quark-works/corne73/PCB/cherry-hotswap/corne73.kicad_pcb

## KiCad design PCB/cherry-hotswap/corne73.kicad_pcb (2026-07-16)

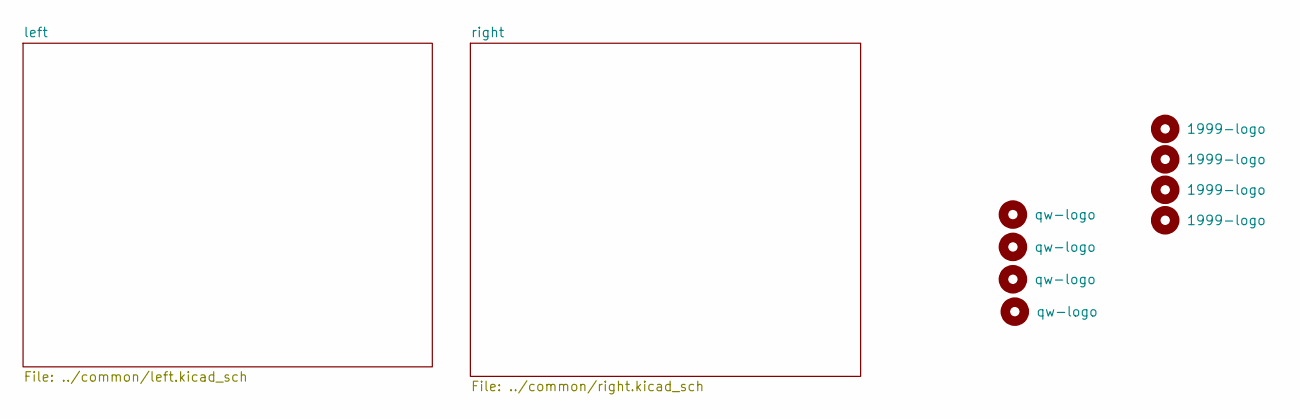
[picture p1: schematic corne73.kicad_sch, Corne]

Parts:
H1, H2, H3, H4: qw-logo; qw new logo silk + copper sm
H5, H6, H7, H8: 1999-logo; 1999 logo md

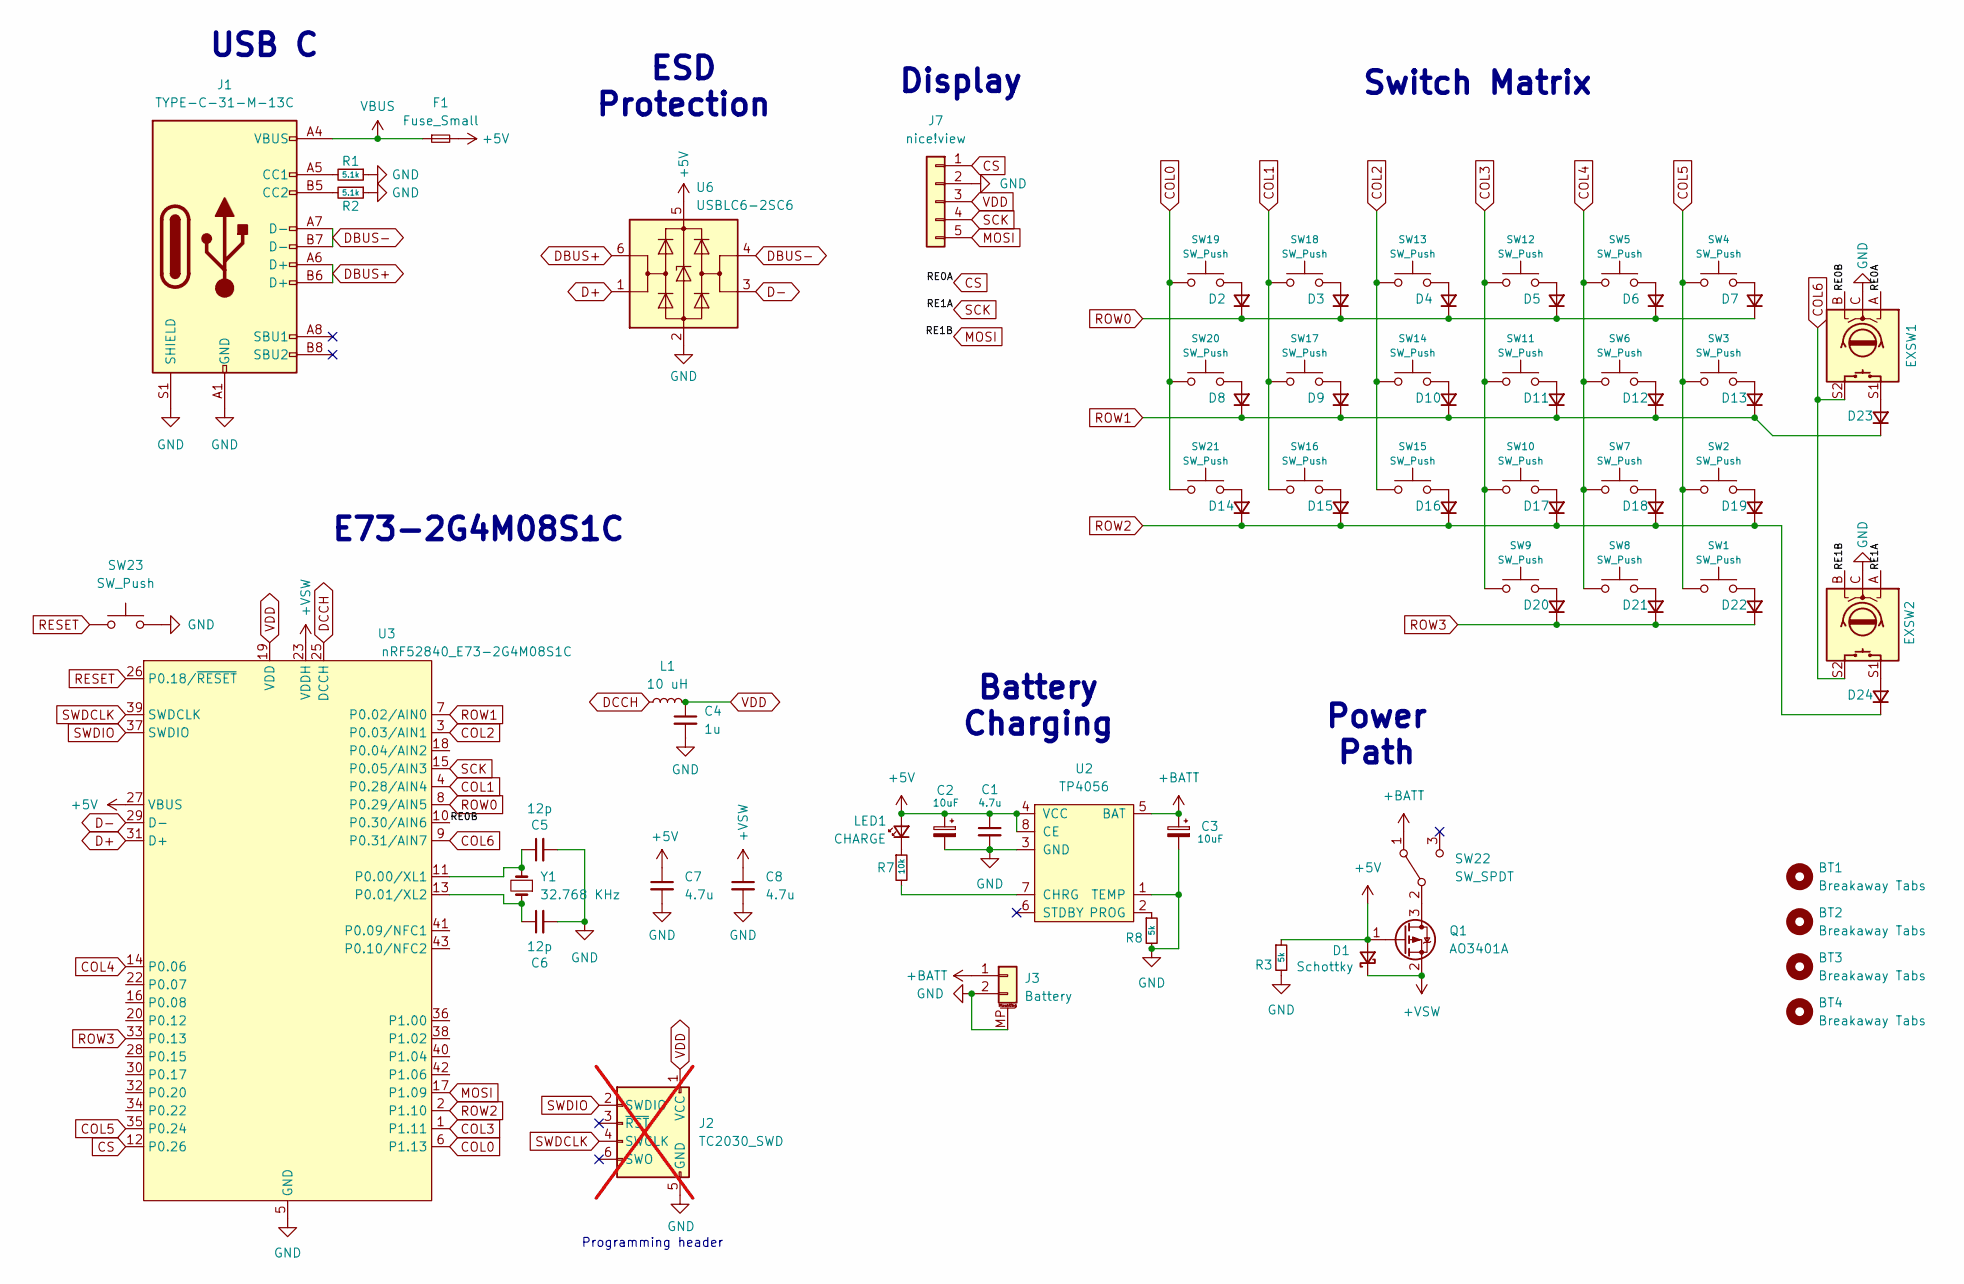
[picture p2: schematic left.kicad_sch, Corne Left]

Parts:
BT1, BT2, BT3, BT4: Breakaway Tabs; Breakaway_Tabs
C1, C7, C8: 4.7u; C_0603_1608Metric
C2, C3: 10uF; CP_EIA-2012-12_Kemet-R
C4: 1u; C_0603_1608Metric
C5, C6: 12p; C_0603_1608Metric
D1: Schottky; D_SOD-123
D2, D3, D4, D5, D6, D7, D8, D9, D10, D11, D12, D13, D14, D15, D16, D17, D18, D19, D20, D21, D22, D23, D24: 1N4148; D_SOD-123
EXSW1, EXSW2: RotaryEncoder_Switch; SwitchCombo+Encoder
F1: Fuse_Small; Fuse_1206_3216Metric
J1: TYPE-C-31-M-13C; JLCPCB Part # C2848620
J2: TC2030_SWD; CON_TC2030_outlined; not fitted
J3: Battery; Molex_Pico-EZmate_78171-0002_1x02-1MP_P1.20mm_Vertical
J7: nice!view; PinHeader_1x05_P2.54mm_Vertical
L1: 10 uH; L_0603_1608Metric; LCSC C92982
LED1: CHARGE; LED_0805_2012Metric
Q1: AO3401A; SOT-23
R1, R2: 5.1k; R_0402_1005Metric
R3, R8: 5k; R_0603_1608Metric
R7: 10k; R_0603_1608Metric
SW1, SW2, SW3, SW4, SW5, SW6, SW7, SW8, SW9, SW10, SW11, SW12, SW13, SW14, SW15, SW16, SW17, SW18, SW19, SW20, SW21: SW_Push; SwitchCombo
SW22: SW_SPDT; SW_SPDT_PCM12; LCSC C136720
SW23: SW_Push; SW_T1A2QR
U2: TP4056; CustomTP4056; LCSC C16581
U3: nRF52840_E73-2G4M08S1C; LCSC C356849
U6: USBLC6-2SC6; SOT-23-6
Y1: 32.768 KHz; Crystal_SMD_2012-2Pin_2.0x1.2mm; LCSC C55208

Connections:
+5V: C1.1, C2.1, C7.1, D1.2 (A), F1.2, LED1.2 (A), Q1.1 (G), R3.1, U2.4 (VCC), U2.8 (CE), U3.27 (VBUS), U6.5 (VBUS)
+BATT: C3.1, J3.1, SW22.1 (A), U2.5 (BAT)
+VSW: C8.1, D1.1 (K), Q1.2 (S), U3.23 (VDDH)
/left/RE0B: EXSW1.B, U3.10 (P0.30/AIN6)
COL0: SW19.2, SW20.2, SW21.2, U3.6 (P1.13)
COL1: SW16.2, SW17.2, SW18.2, U3.4 (P0.28/AIN4)
COL2: SW13.2, SW14.2, SW15.2, U3.3 (P0.03/AIN1)
COL3: SW9.2, SW10.2, SW11.2, SW12.2, U3.1 (P1.11)
COL4: SW5.2, SW6.2, SW7.2, SW8.2, U3.14 (P0.06)
COL5: SW1.2, SW2.2, SW3.2, SW4.2, U3.35 (P0.24)
COL6: EXSW1.S2, EXSW2.S2, U3.9 (P0.31/AIN7)
CS: EXSW1.A, J7.1, U3.12 (P0.26)
D+: U3.31 (D+), U6.1 (I/O1)
D-: U3.29 (D-), U6.3 (I/O2)
DBUS+: J1.A6 (D+), J1.B6 (D+), U6.6 (I/O1)
DBUS-: J1.A7 (D-), J1.B7 (D-), U6.4 (I/O2)
DCCH: L1.1, U3.25 (DCCH)
GND: C1.2, C2.2, C3.2, C4.2, C5.2, C6.2, C7.2, C8.2, EXSW1.C, EXSW2.C, J1.A1 (GND), J1.A12 (GND), J1.B1 (GND), J1.B12 (GND), J1.S1 (SHIELD), J2.5 (GND), J3.2, J3.MP (MountPin), J7.2, R1.1, R2.1, R3.2, R8.2, SW23.2, U2.1 (TEMP), U2.3 (GND), U3.5 (GND), U3.21 (GND), U3.24 (GND), U6.2 (GND)
MOSI: EXSW2.B, J7.5, U3.17 (P1.09)
unnamed: D2.2 (A), SW19.1
unnamed: D3.2 (A), SW18.1
unnamed: D4.2 (A), SW13.1
unnamed: D5.2 (A), SW12.1
unnamed: D6.2 (A), SW5.1
unnamed: D7.2 (A), SW4.1
unnamed: D8.2 (A), SW20.1
unnamed: D9.2 (A), SW17.1
unnamed: D10.2 (A), SW14.1
unnamed: D11.2 (A), SW11.1
unnamed: D12.2 (A), SW6.1
unnamed: D13.2 (A), SW3.1
unnamed: D14.2 (A), SW21.1
unnamed: D15.2 (A), SW16.1
unnamed: D16.2 (A), SW15.1
unnamed: D17.2 (A), SW10.1
unnamed: D18.2 (A), SW7.1
unnamed: D19.2 (A), SW2.1
unnamed: D20.2 (A), SW9.1
unnamed: D21.2 (A), SW8.1
unnamed: D22.2 (A), SW1.1
unnamed: D23.2 (A), EXSW1.S1
unnamed: D24.2 (A), EXSW2.S1
unnamed: J1.A5 (CC1), R1.2
unnamed: J1.B5 (CC2), R2.2
unnamed: LED1.1 (K), R7.1
unnamed: Q1.3 (D), SW22.2 (B)
unnamed: R7.2, U2.7 (CHRG)
unnamed: R8.1, U2.2 (PROG)
unnamed: C5.1, U3.11 (P0.00/XL1), Y1.2
unnamed: C6.1, U3.13 (P0.01/XL2), Y1.1
RESET: SW23.1, U3.26 (P0.18/~RESET)
ROW0: D2.1 (K), D3.1 (K), D4.1 (K), D5.1 (K), D6.1 (K), D7.1 (K), U3.8 (P0.29/AIN5)
ROW1: D8.1 (K), D9.1 (K), D10.1 (K), D11.1 (K), D12.1 (K), D13.1 (K), D23.1 (K), U3.7 (P0.02/AIN0)
ROW2: D14.1 (K), D15.1 (K), D16.1 (K), D17.1 (K), D18.1 (K), D19.1 (K), D24.1 (K), U3.2 (P1.10)
ROW3: D20.1 (K), D21.1 (K), D22.1 (K), U3.33 (P0.13)
SCK: EXSW2.A, J7.4, U3.15 (P0.05/AIN3)
SWDCLK: J2.4 (SWCLK), U3.39 (SWDCLK)
SWDIO: J2.2 (SWDIO), U3.37 (SWDIO)
VBUS: F1.1, J1.A4 (VBUS), J1.A9 (VBUS), J1.B4 (VBUS), J1.B9 (VBUS)
VDD: C4.1, J2.1 (VCC), J7.3, L1.2, U3.19 (VDD)

Notes on the sheet:
Display
Power Path
USB C
Battery Charging
Programming header
E73-2G4M08S1C
Switch Matrix
ESD Protection

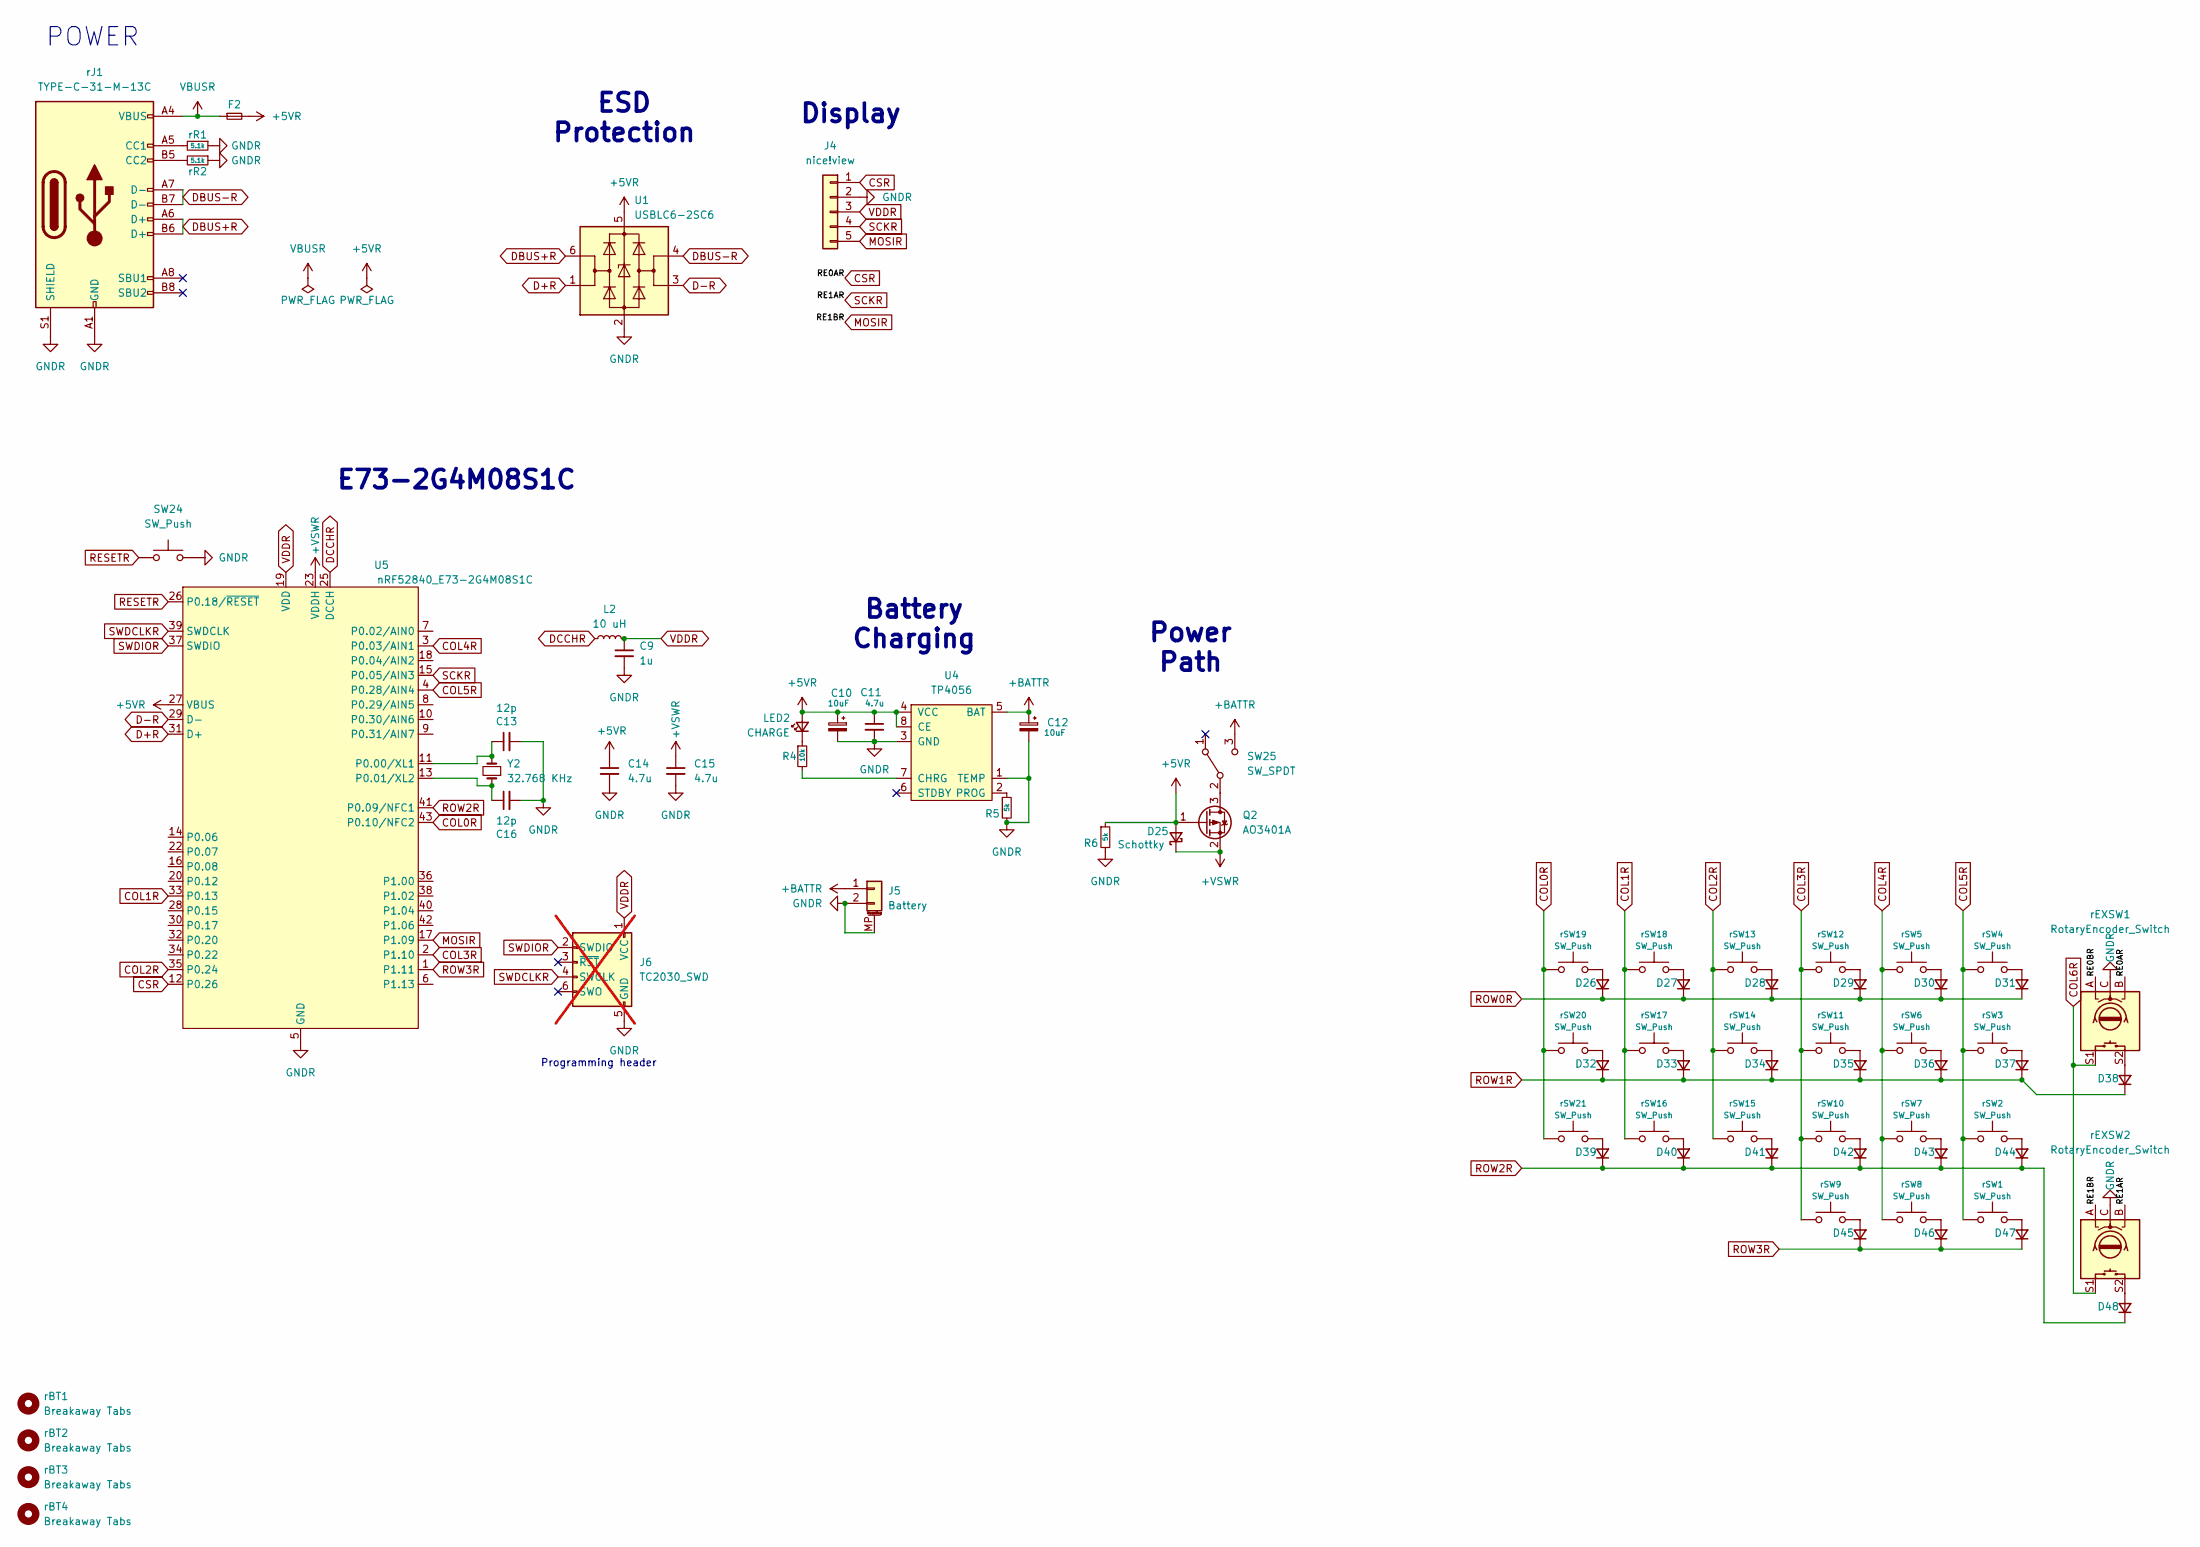
[picture p3: schematic right.kicad_sch, Corne Right]

Parts:
C9: 1u; C_0603_1608Metric
C10, C12: 10uF; CP_EIA-2012-12_Kemet-R
C11, C14, C15: 4.7u; C_0603_1608Metric
C13, C16: 12p; C_0603_1608Metric
D25: Schottky; D_SOD-123
D26, D27, D28, D29, D30, D31, D32, D33, D34, D35, D36, D37, D38, D39, D40, D41, D42, D43, D44, D45, D46, D47, D48: 1N4148; D_SOD-123
F2: Fuse_Small; Fuse_1206_3216Metric
J4: nice!view; PinHeader_1x05_P2.54mm_Vertical
J5: Battery; Molex_Pico-EZmate_78171-0002_1x02-1MP_P1.20mm_Vertical
J6: TC2030_SWD; CON_TC2030_outlined; not fitted
L2: 10 uH; L_0603_1608Metric; LCSC C92982
LED2: CHARGE; LED_0805_2012Metric
Q2: AO3401A; SOT-23
R4: 10k; R_0603_1608Metric
R5, R6: 5k; R_0603_1608Metric
SW24: SW_Push; SW_T1A2QR
SW25: SW_SPDT; SW_SPDT_PCM12; LCSC C136720
U1: USBLC6-2SC6; SOT-23-6
U4: TP4056; CustomTP4056; LCSC C16581
U5: nRF52840_E73-2G4M08S1C; LCSC C356849
Y2: 32.768 KHz; Crystal_SMD_2012-2Pin_2.0x1.2mm; LCSC C55208
rBT1, rBT2, rBT3, rBT4: Breakaway Tabs; Breakaway_Tabs
rEXSW1, rEXSW2: RotaryEncoder_Switch; SwitchCombo+Encoder
rJ1: TYPE-C-31-M-13C; JLCPCB Part # C2848620
rR1, rR2: 5.1k; R_0402_1005Metric
rSW1, rSW2, rSW3, rSW4, rSW5, rSW6, rSW7, rSW8, rSW9, rSW10, rSW11, rSW12, rSW13, rSW14, rSW15, rSW16, rSW17, rSW18, rSW19, rSW20, rSW21: SW_Push; SwitchCombo

Connections:
+5VR: C10.1, C11.1, C14.1, D25.2 (A), F2.2, LED2.2 (A), Q2.1 (G), R6.1, U1.5 (VBUS), U4.4 (VCC), U4.8 (CE), U5.27 (VBUS)
+BATTR: C12.1, J5.1, SW25.3 (C), U4.5 (BAT)
+VSWR: C15.1, D25.1 (K), Q2.2 (S), U5.23 (VDDH)
/right/RE0BR: rEXSW1.A
COL0R: U5.43 (P0.10/NFC2), rSW19.2, rSW20.2, rSW21.2
COL1R: U5.33 (P0.13), rSW16.2, rSW17.2, rSW18.2
COL2R: U5.35 (P0.24), rSW13.2, rSW14.2, rSW15.2
COL3R: U5.2 (P1.10), rSW9.2, rSW10.2, rSW11.2, rSW12.2
COL4R: U5.3 (P0.03/AIN1), rSW5.2, rSW6.2, rSW7.2, rSW8.2
COL5R: U5.4 (P0.28/AIN4), rSW1.1, rSW2.2, rSW3.2, rSW4.2
COL6R: rEXSW1.S1, rEXSW2.S1
CSR: J4.1, U5.12 (P0.26), rEXSW1.B
D+R: U1.1 (I/O1), U5.31 (D+)
D-R: U1.3 (I/O2), U5.29 (D-)
DBUS+R: U1.6 (I/O1), rJ1.A6 (D+), rJ1.B6 (D+)
DBUS-R: U1.4 (I/O2), rJ1.A7 (D-), rJ1.B7 (D-)
DCCHR: L2.1, U5.25 (DCCH)
GNDR: C9.2, C10.2, C11.2, C12.2, C13.2, C14.2, C15.2, C16.2, J4.2, J5.2, J5.MP (MountPin), J6.5 (GND), R5.2, R6.2, SW24.2, U1.2 (GND), U4.1 (TEMP), U4.3 (GND), U5.5 (GND), U5.21 (GND), U5.24 (GND), rEXSW1.C, rEXSW2.C, rJ1.A1 (GND), rJ1.A12 (GND), rJ1.B1 (GND), rJ1.B12 (GND), rJ1.S1 (SHIELD), rR1.1, rR2.1
MOSIR: J4.5, U5.17 (P1.09), rEXSW2.A
unnamed: D26.2 (A), rSW19.1
unnamed: D27.2 (A), rSW18.1
unnamed: D28.2 (A), rSW13.1
unnamed: D29.2 (A), rSW12.1
unnamed: D30.2 (A), rSW5.1
unnamed: D31.2 (A), rSW4.1
unnamed: D32.2 (A), rSW20.1
unnamed: D33.2 (A), rSW17.1
unnamed: D34.2 (A), rSW14.1
unnamed: D35.2 (A), rSW11.1
unnamed: D36.2 (A), rSW6.1
unnamed: D37.2 (A), rSW3.1
unnamed: D38.2 (A), rEXSW1.S2
unnamed: D39.2 (A), rSW21.1
unnamed: D40.2 (A), rSW16.1
unnamed: D41.2 (A), rSW15.1
unnamed: D42.2 (A), rSW10.1
unnamed: D43.2 (A), rSW7.1
unnamed: D44.2 (A), rSW2.1
unnamed: D45.2 (A), rSW9.1
unnamed: D46.2 (A), rSW8.1
unnamed: D47.2 (A), rSW1.2
unnamed: D48.2 (A), rEXSW2.S2
unnamed: LED2.1 (K), R4.1
unnamed: Q2.3 (D), SW25.2 (B)
unnamed: R4.2, U4.7 (CHRG)
unnamed: R5.1, U4.2 (PROG)
unnamed: C13.1, U5.11 (P0.00/XL1), Y2.2
unnamed: C16.1, U5.13 (P0.01/XL2), Y2.1
unnamed: rJ1.A5 (CC1), rR1.2
unnamed: rJ1.B5 (CC2), rR2.2
RESETR: SW24.1, U5.26 (P0.18/~RESET)
ROW0R: D26.1 (K), D27.1 (K), D28.1 (K), D29.1 (K), D30.1 (K), D31.1 (K)
ROW1R: D32.1 (K), D33.1 (K), D34.1 (K), D35.1 (K), D36.1 (K), D37.1 (K), D38.1 (K)
ROW2R: D39.1 (K), D40.1 (K), D41.1 (K), D42.1 (K), D43.1 (K), D44.1 (K), D48.1 (K), U5.41 (P0.09/NFC1)
ROW3R: D45.1 (K), D46.1 (K), D47.1 (K), U5.1 (P1.11)
SCKR: J4.4, U5.15 (P0.05/AIN3), rEXSW2.B
SWDCLKR: J6.4 (SWCLK), U5.39 (SWDCLK)
SWDIOR: J6.2 (SWDIO), U5.37 (SWDIO)
VBUSR: F2.1, rJ1.A4 (VBUS), rJ1.A9 (VBUS), rJ1.B4 (VBUS), rJ1.B9 (VBUS)
VDDR: C9.1, J4.3, J6.1 (VCC), L2.2, U5.19 (VDD)

Notes on the sheet:
Display
Power Path
POWER
Battery Charging
E73-2G4M08S1C
Programming header
ESD Protection

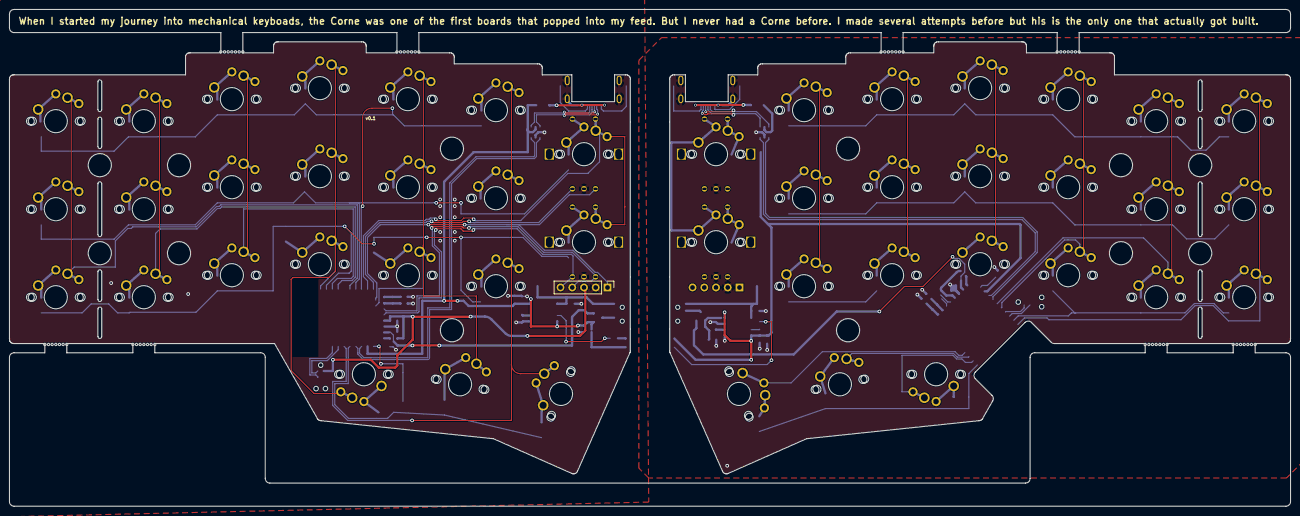
[picture p4: board corne73.kicad_pcb from above]

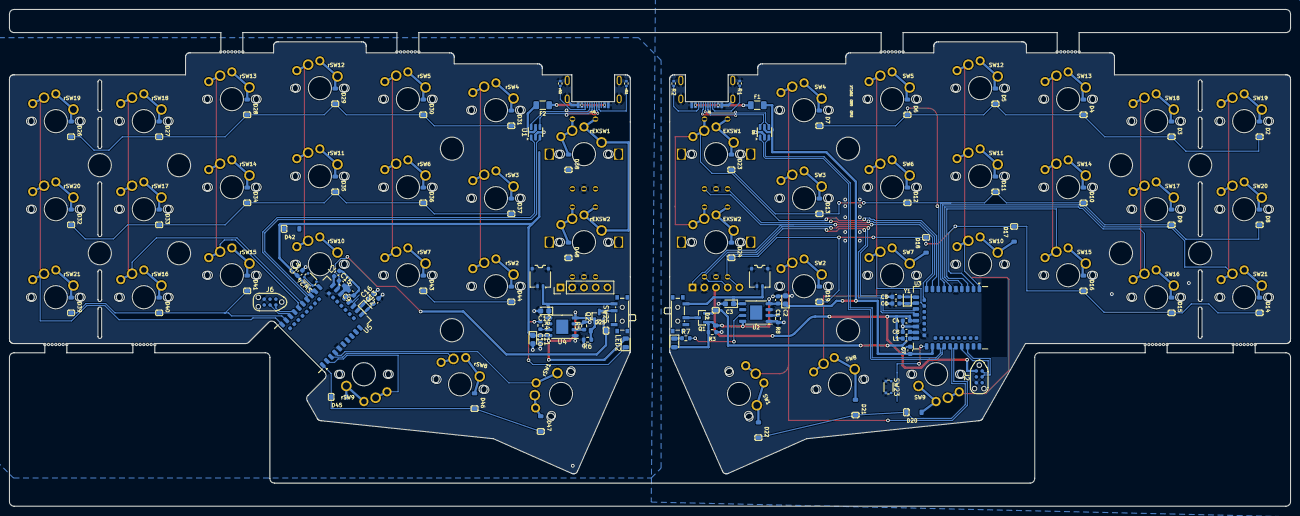
[picture p5: board corne73.kicad_pcb from below]

Board: 2 copper layers, 277.2 x 107.5 mm, 164 parts (109 on the bottom side), 119 nets.
