quark-works/corne73/(commit log)

2026-07-02 Catching up
    [corne73.kicad_pcb, corne73.kicad_sch, left.kicad_sch, right.kicad_sch]
2026-07-02 Changed footprints, made decisions
    [corne73.kicad_pcb, left.kicad_sch, right.kicad_sch]
2026-07-06 More changes
    [corne73.kicad_pcb, left.kicad_sch, right.kicad_sch]
2026-07-14 Left hand routed
    [corne73.kicad_pcb, left.kicad_sch]
2026-07-16 Started work on right side
    [corne73.kicad_pcb, corne73.kicad_sch, left.kicad_sch, right.kicad_sch]
